tormodhagen/esp32-ecg/EKG.pdf

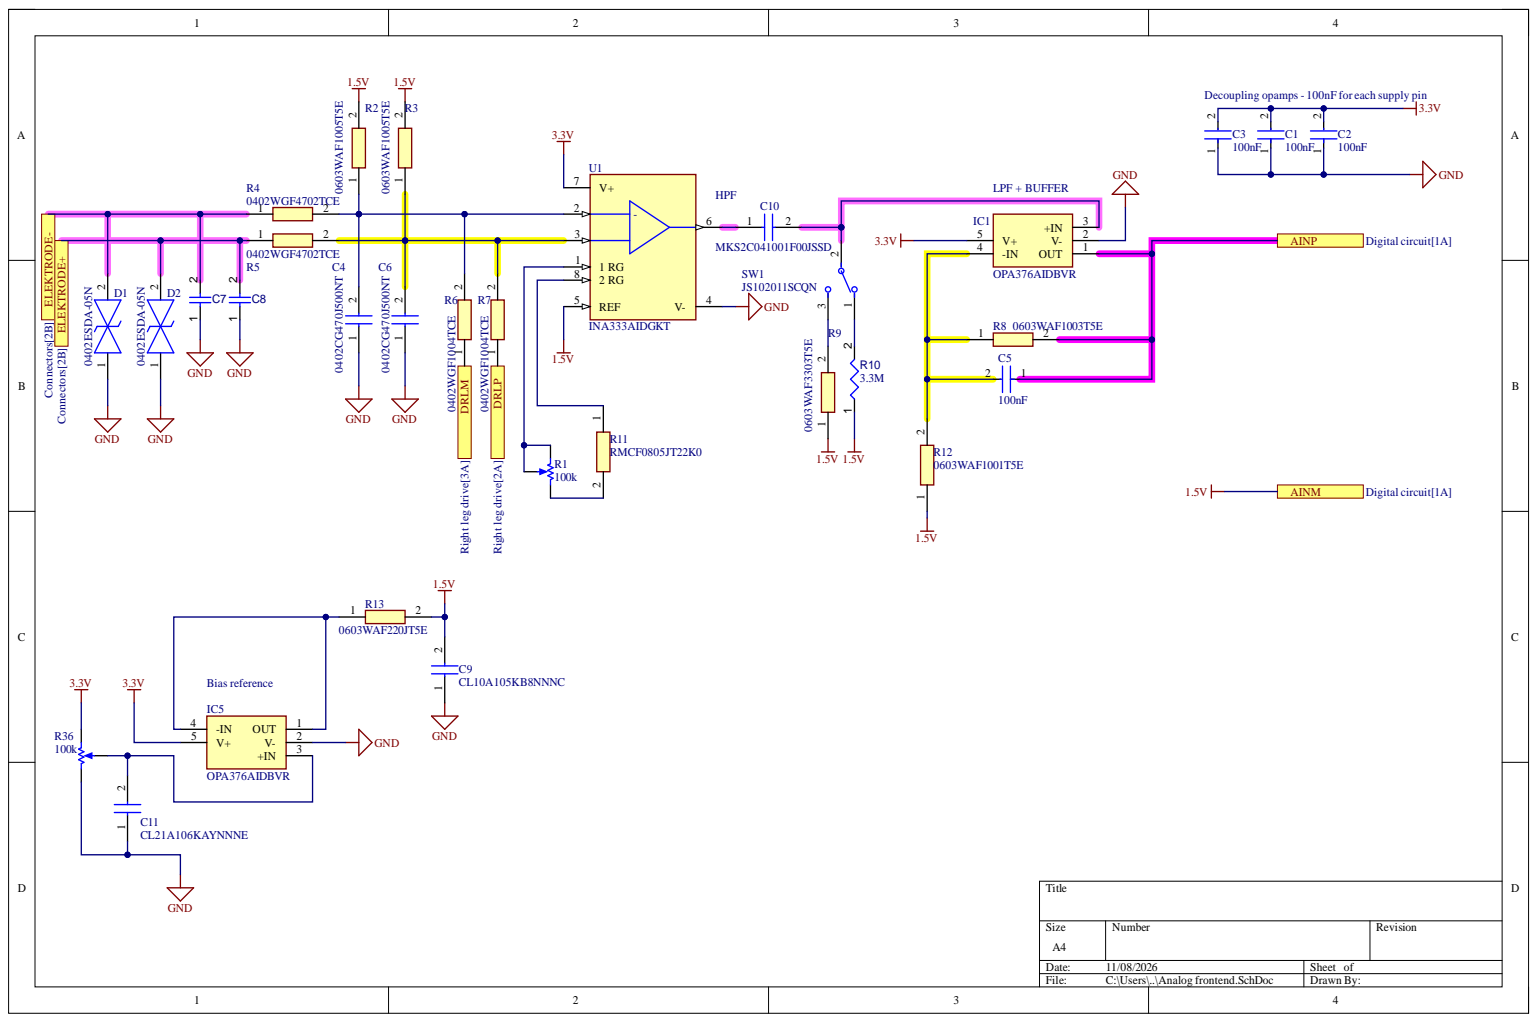
[picture p6: page 1]

DRLM Right leg drive[3A]

DRLP Right leg drive[2A]

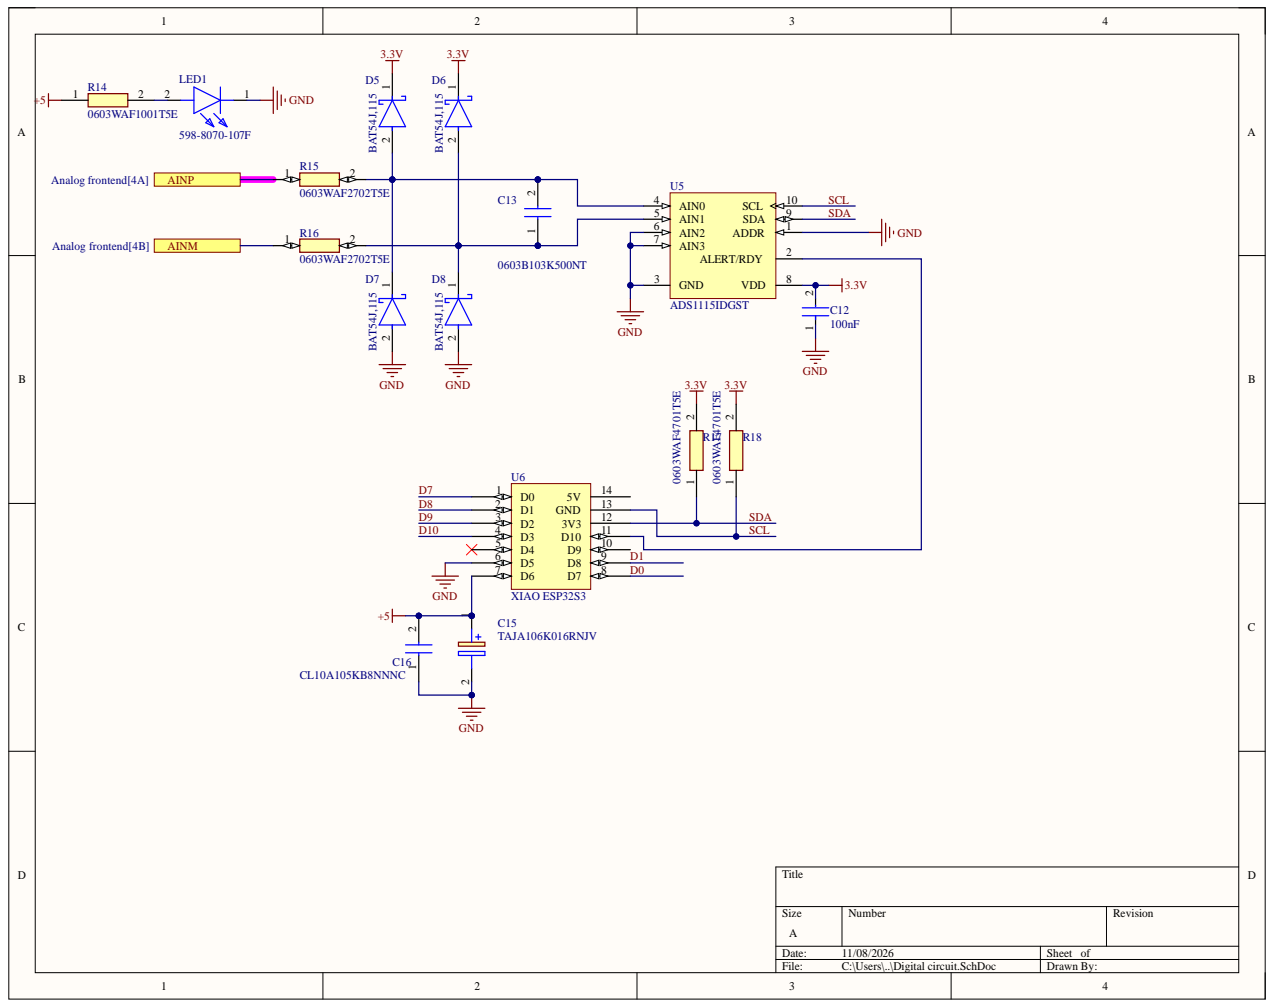
[picture p7: page 2]

AIN2 6

GND 3

Size | Number | Revision

Date: 11/08/2026 | Sheet of
File: C:\Users\..\Digital circuit.SchDoc | Drawn By:

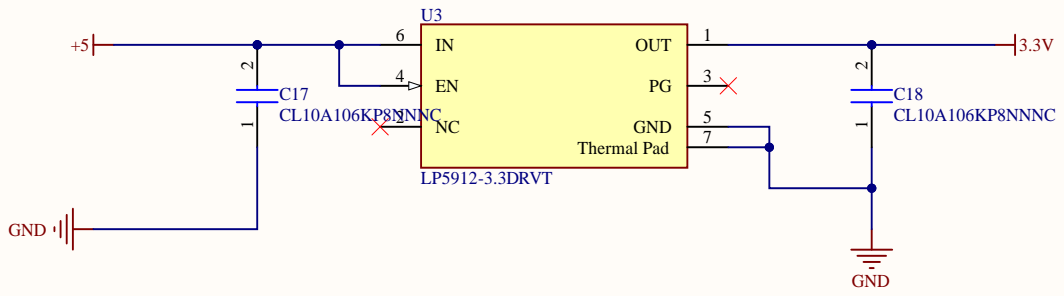
[picture p8: page 3]

Size | Nu m b er | Revisio n

Date: 1/0 8/2 6 | Sheet o
File: C:\Users\..\Power su p ply.SchDo c | Drawn B y

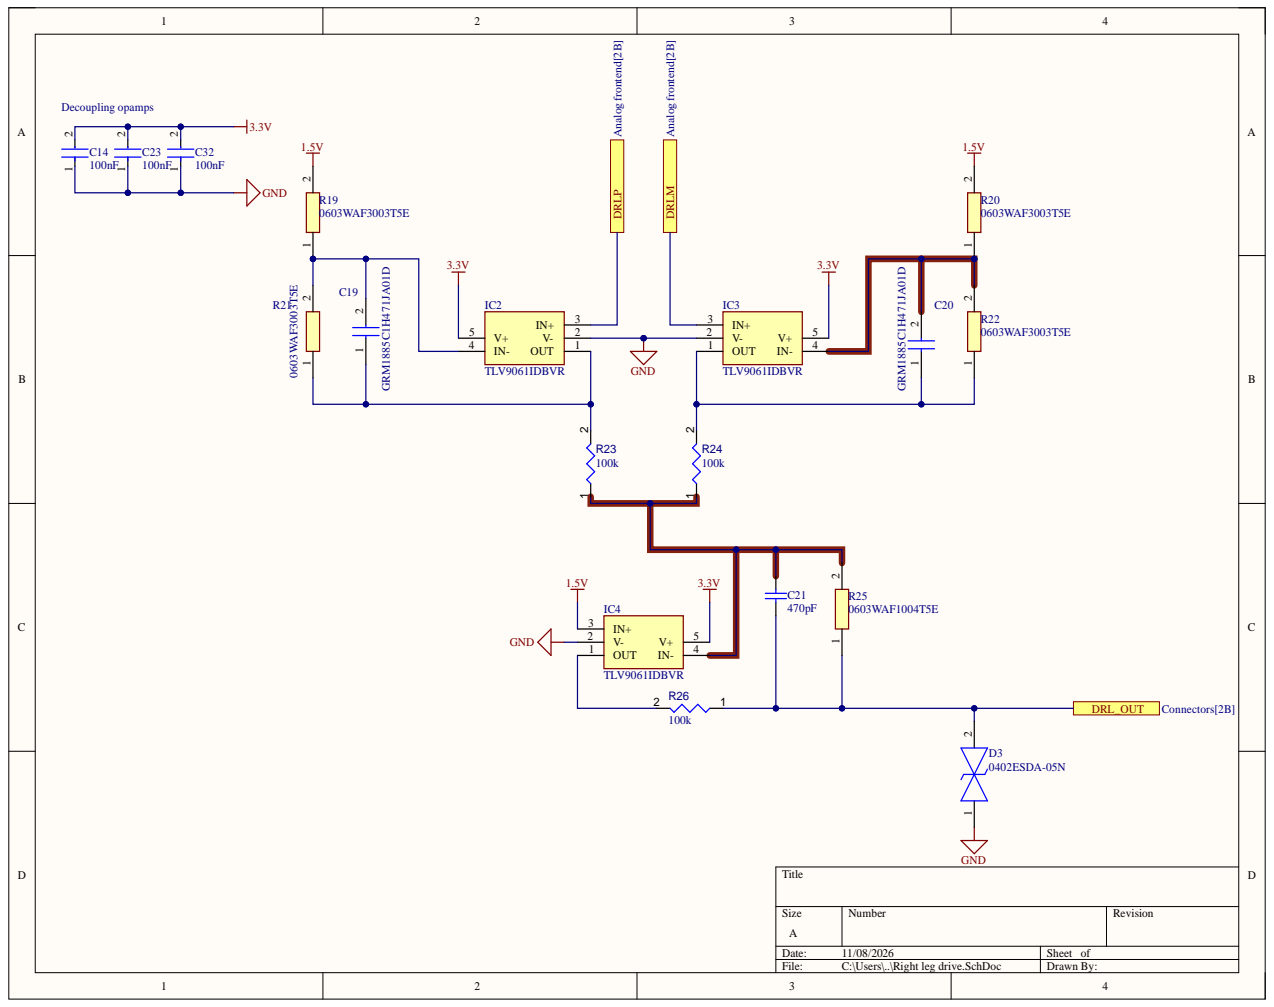
[picture p9: page 4]

Size | Nu m b er | Revisio n

Date: 1/0 8/2 6 | Sheet o
File: C:\Users\..\Rig ht leg d rive.SchDo c | Drawn B y

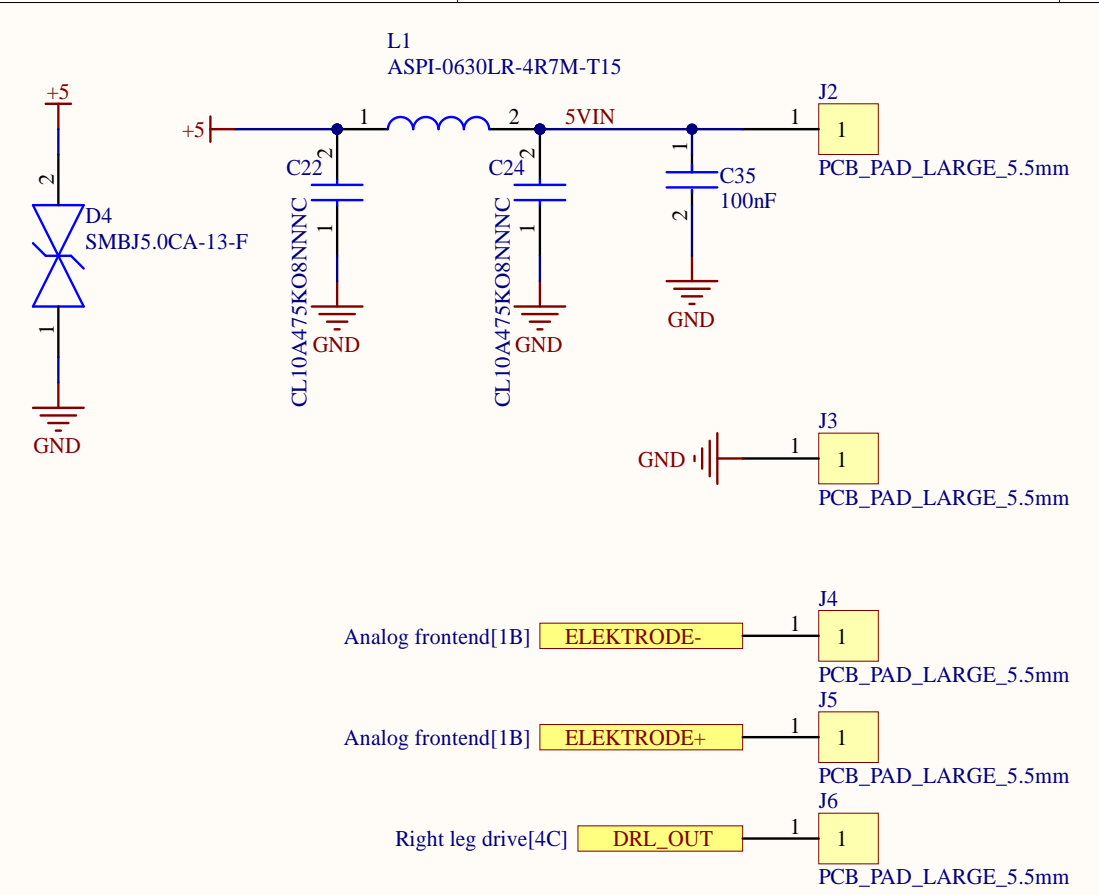
[picture p10: page 5]

Size | Number | Revision

Date: 11/08/2026 | Sheet of
File: C:\Users\..\Connectors.SchDoc | Drawn By:

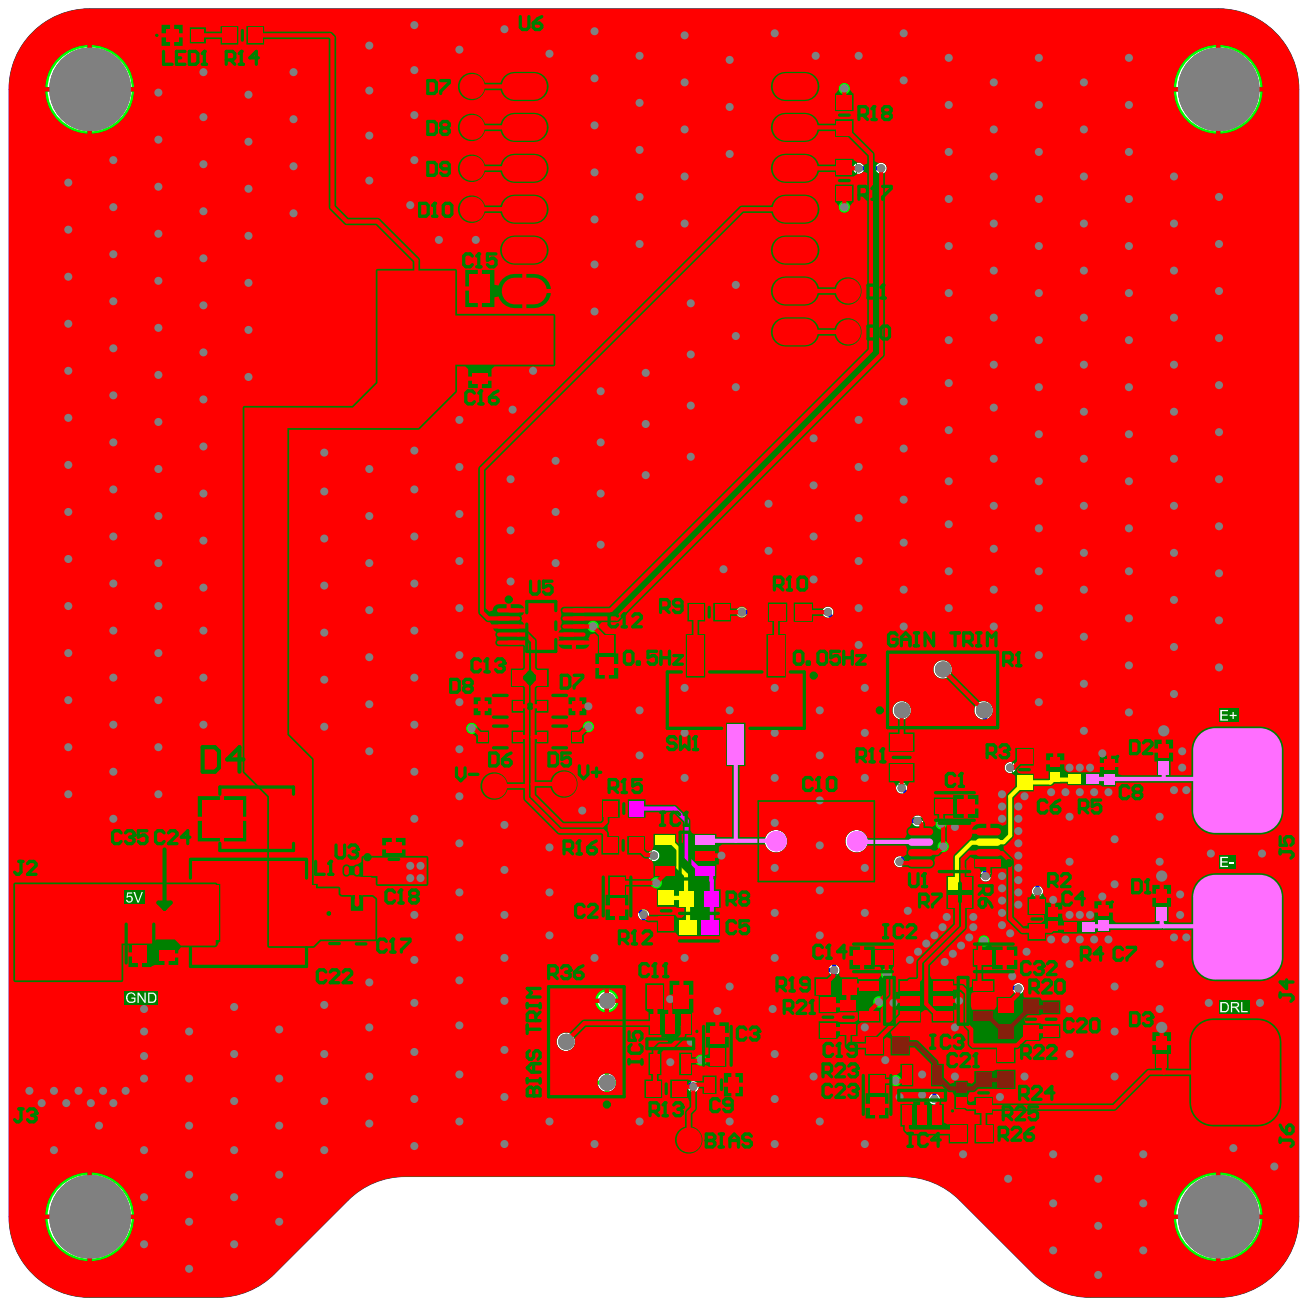
[picture p11: page 6]
