tormodhagen/esp32-ecg/(list of files, drawings)

Other design files:
Altium Docs/Analog frontend.SchDoc
Altium Docs/Connectors.SchDoc
Altium Docs/Digital circuit.SchDoc
Altium Docs/EKG.PrjPcb
Altium Docs/PCB.PcbDoc
Altium Docs/Power supply.SchDoc
Altium Docs/Right leg drive.SchDoc
