tormodhagen/esp32-ecg/firmware/src/web_config.h

#pragma once
constexpr uint32_t BOOT_WINDOW_MS = 8000;
constexpr uint32_t PORTAL_TIMEOUT_MS = 180000;
constexpr uint32_t WIFI_CONNECT_TIMEOUT_MS = 30000;
// Password for the temporary configuration access point (at least 8 chars).
constexpr char SETUP_AP_PASSWORD[] = "ecg-setup";
